nastea1/nfc_card/gallery/antenna.png

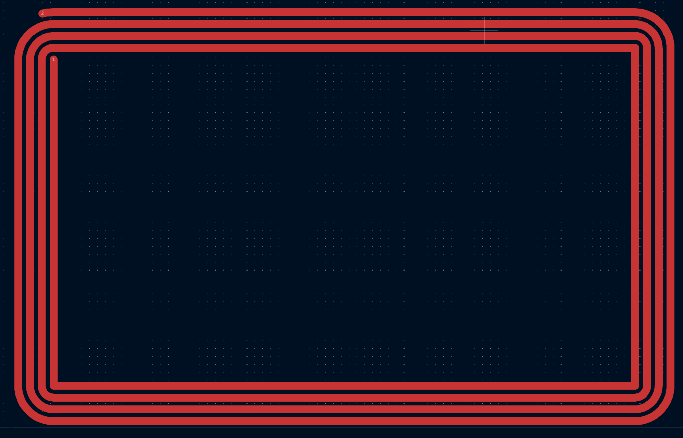
gallery/antenna.png
