nastea1/nfc_card/gallery/back.png

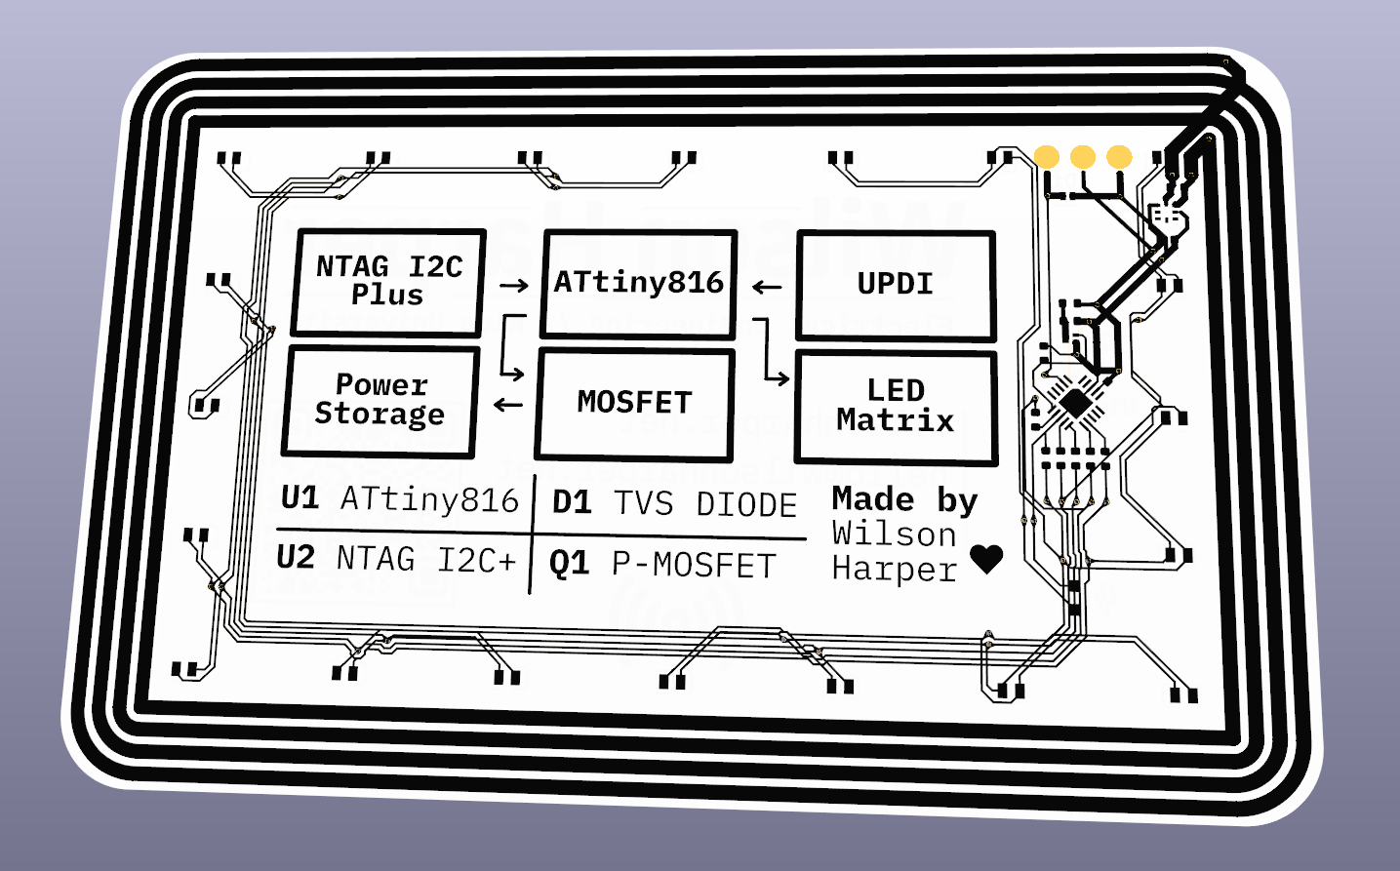
gallery/back.png
