nastea1/nfc_card/gallery/capacitor.png

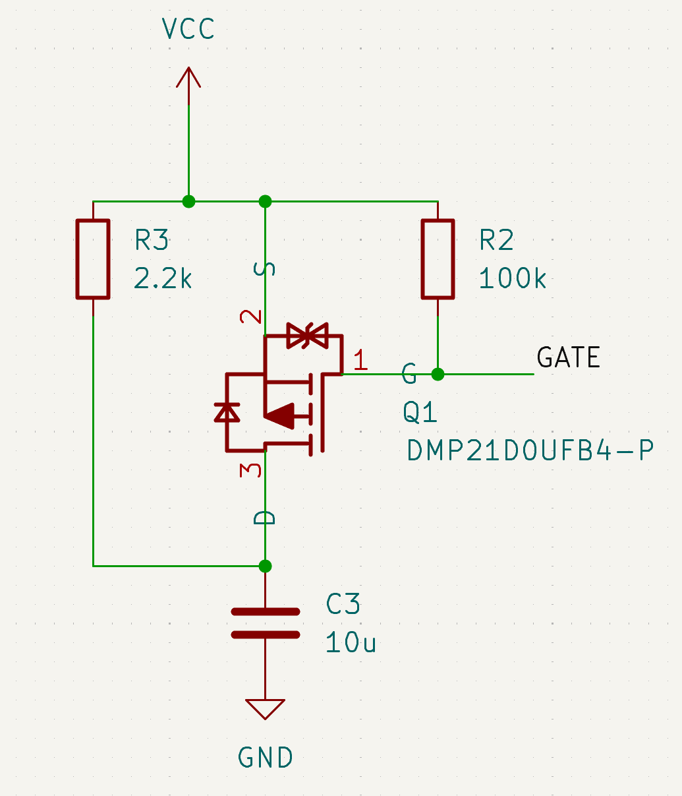
gallery/capacitor.png
