nastea1/nfc_card/gallery/in_hand.jpg

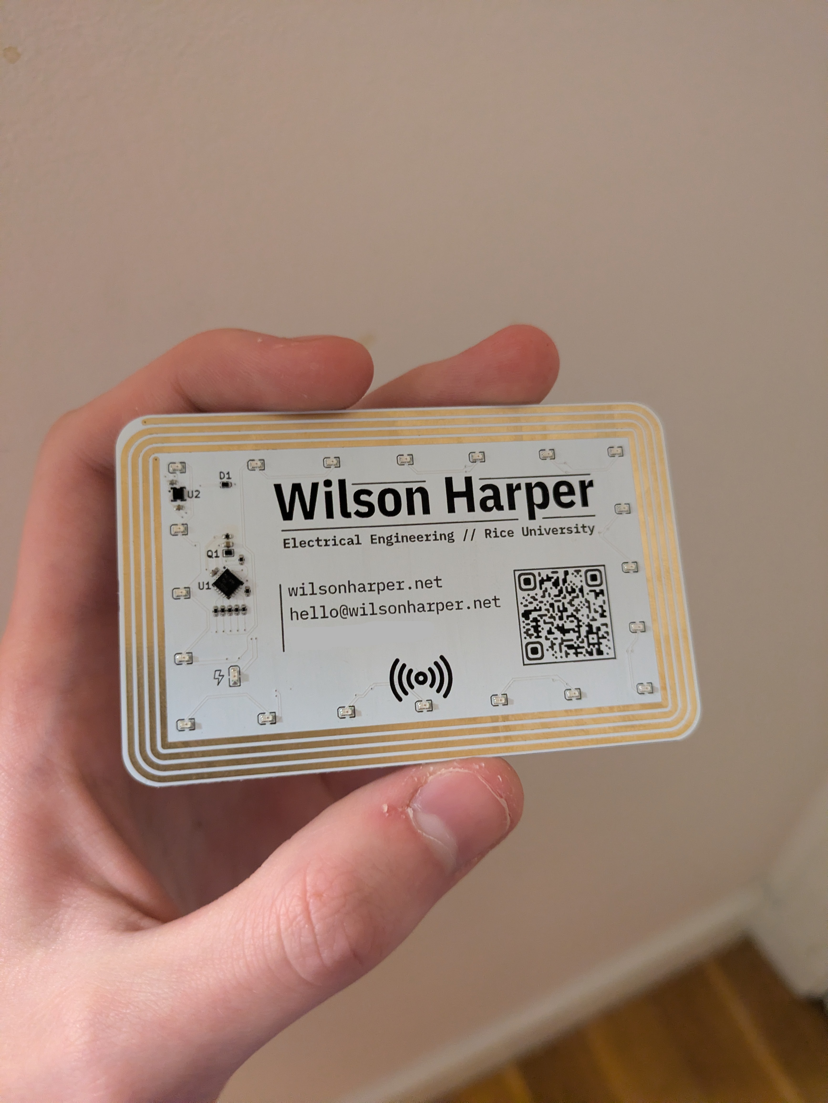
gallery/in_hand.jpg
