nastea1/nfc_card/gallery/in_hand_back.jpg

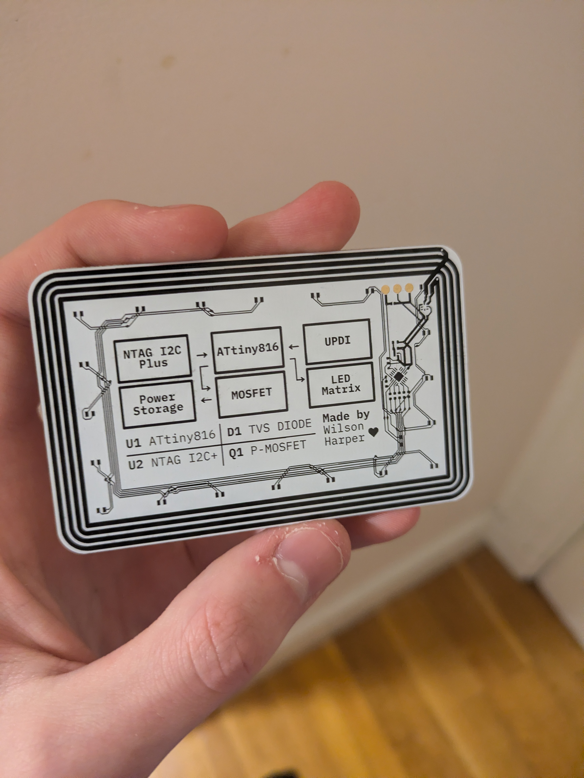
gallery/in_hand_back.jpg
