nastea1/nfc_card/gallery/new_sch.png

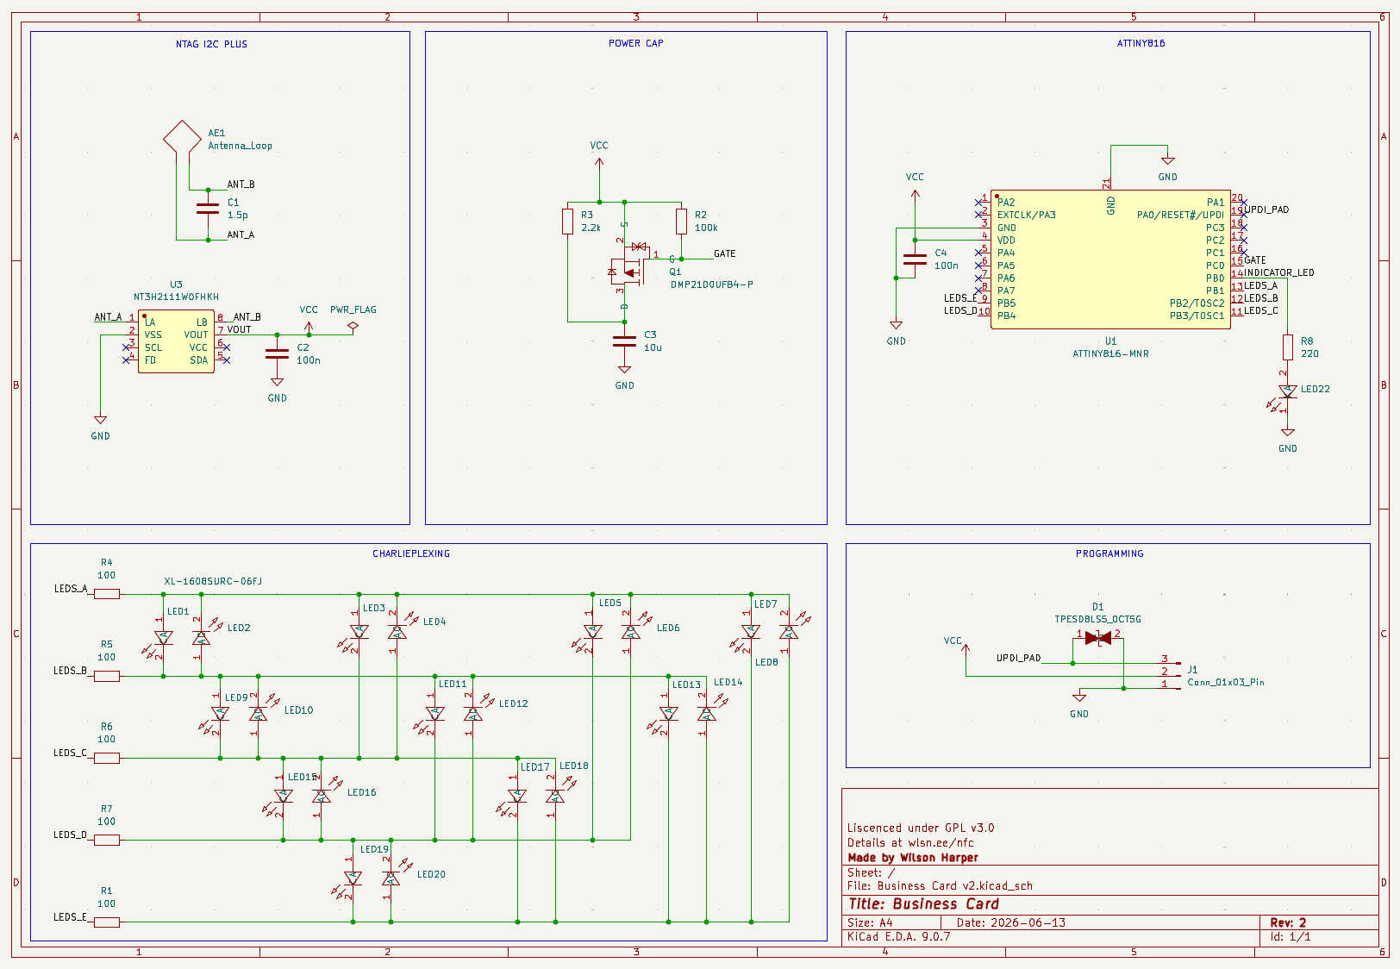
gallery/new_sch.png
