nastea1/nfc_card/gallery/pads.png

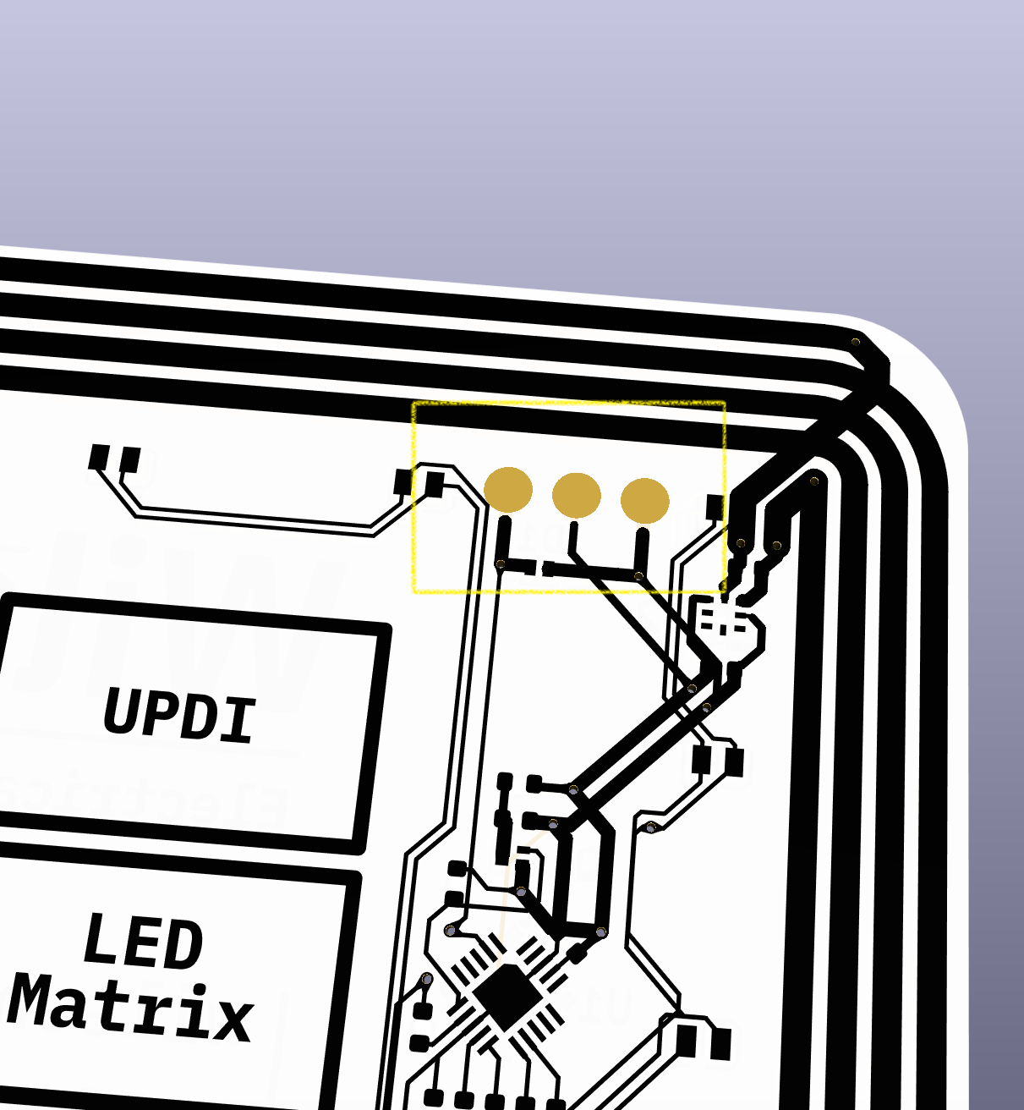
gallery/pads.png
