nastea1/nfc_card/gallery/sch1.png

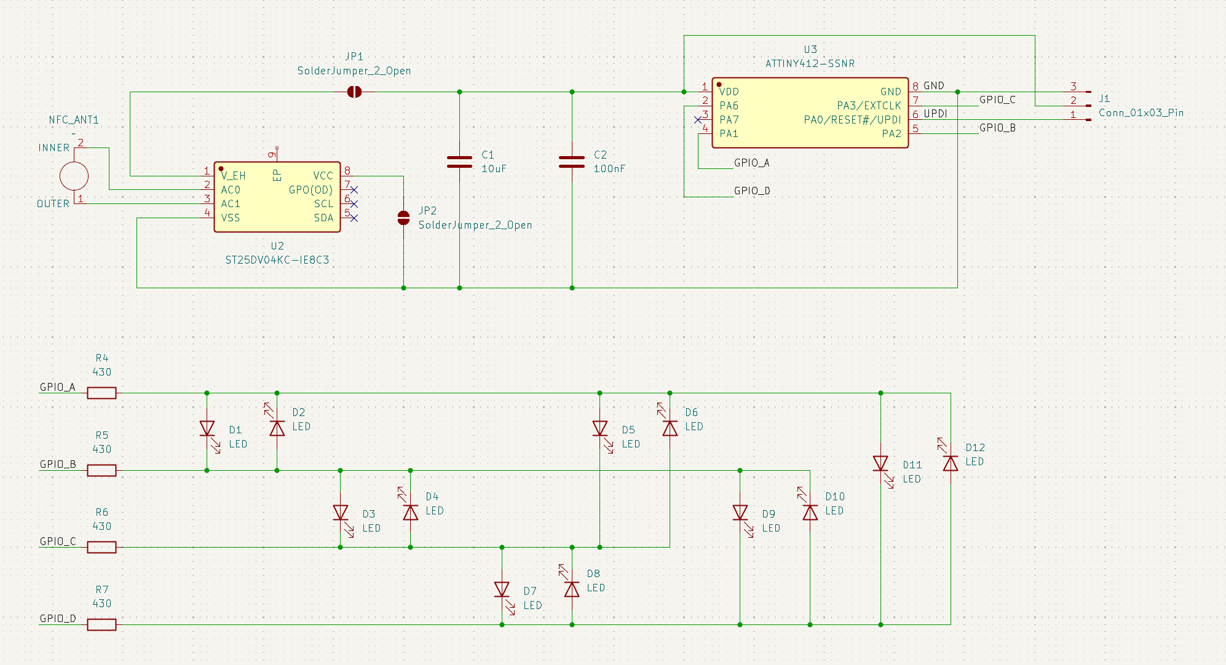
gallery/sch1.png
