nastea1/nfc_card/gallery/st_calc.png

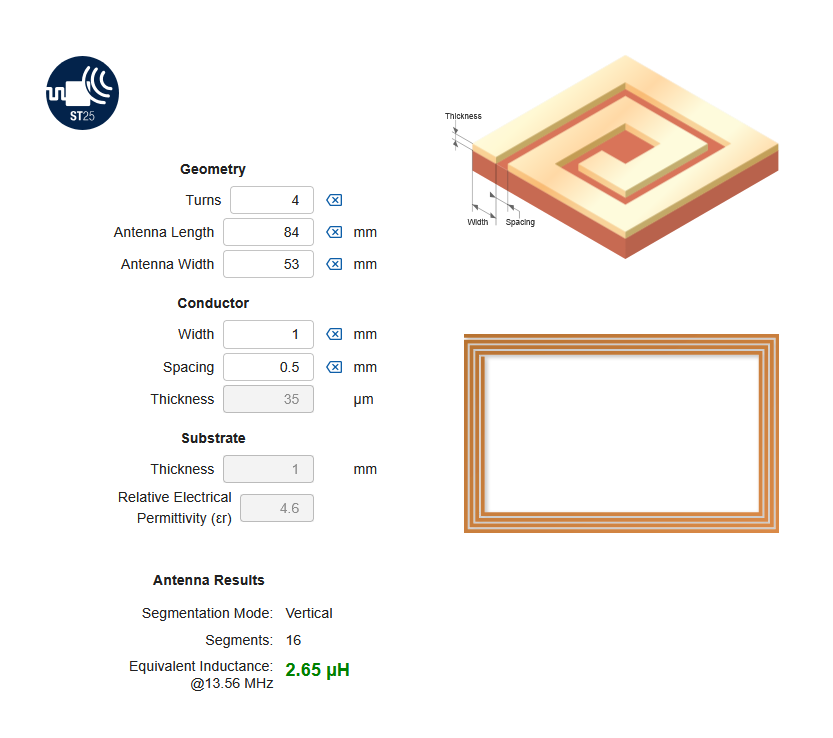
gallery/st_calc.png
