nastea1/nfc_card/gallery/stack.jpg

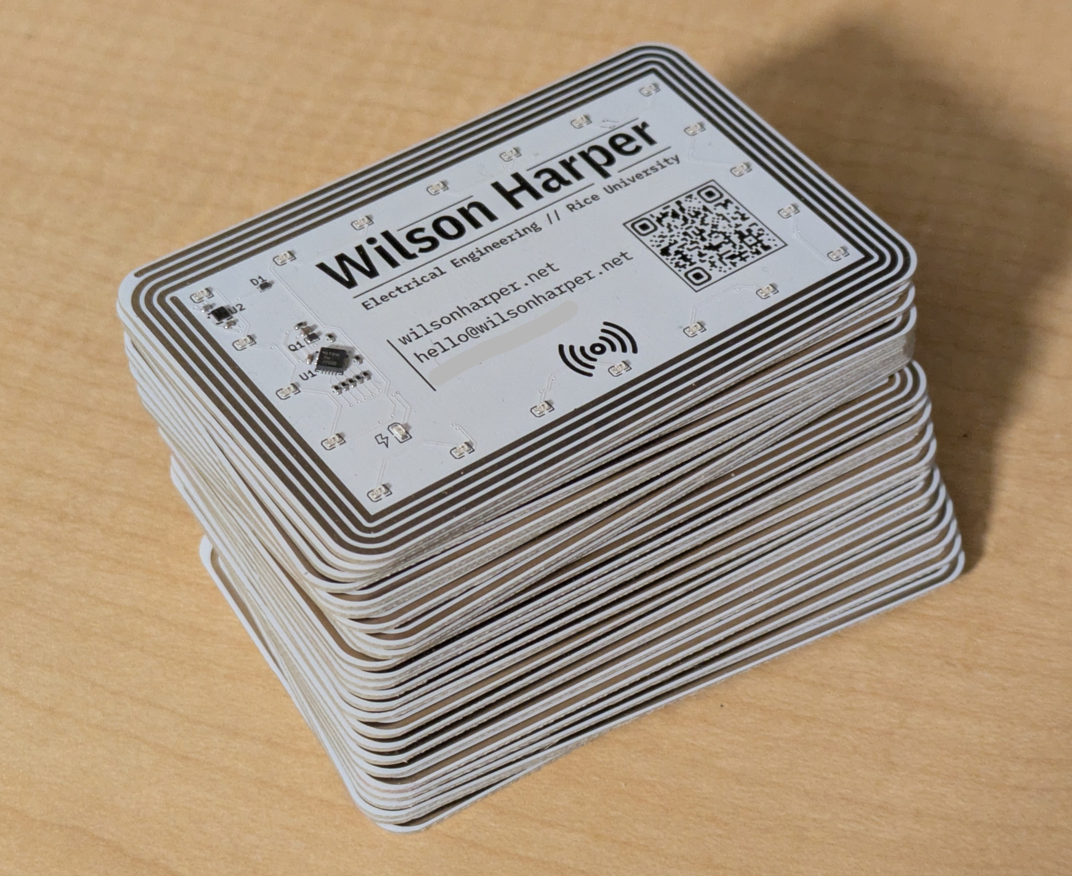
gallery/stack.jpg
