nastea1/nfc_card/hardware/Business Card v2.kicad_pcb

## KiCad design hardware/Business Card v2.kicad_pcb (2026-10-29)

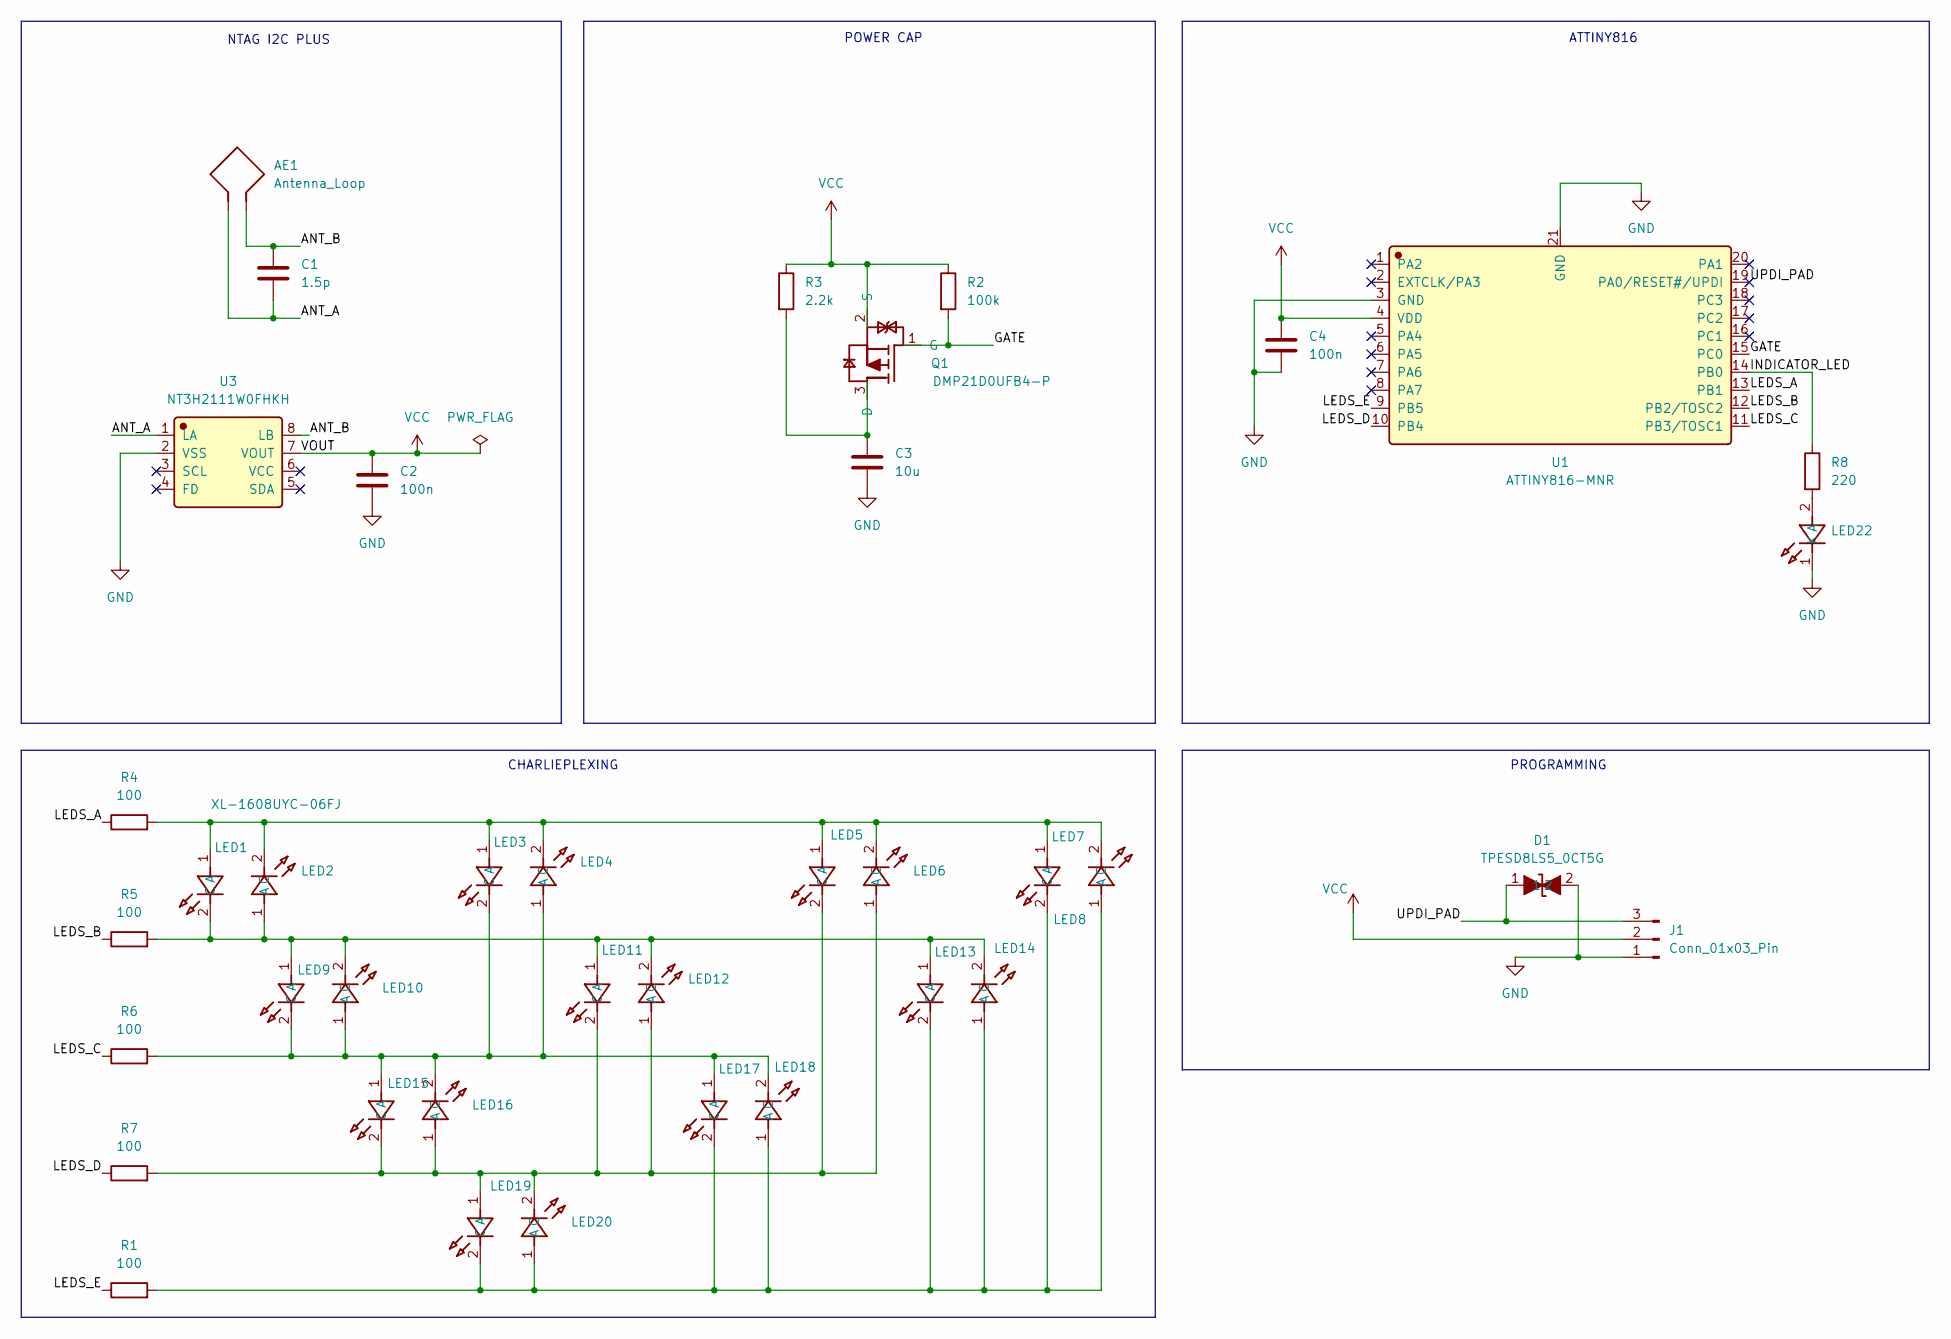
[picture p20: schematic Business Card v2.kicad_sch, Business Card]

Parts:
AE1: Antenna_Loop; Antenna V3
C1: 1.5p; C_0402_1005Metric; LCSC C1552
C2, C4: 100n; C_0402_1005Metric; LCSC C1525
C3: 10u; C_0402_1005Metric; LCSC C15525
D1: TPESD8LS5_0CT5G; TPESD8L3_3CT5G; Manufacturer Part TPESD8LS5.0CT5G; LCSC C2827551
J1: Conn_01x03_Pin; Offset UPDI
LED1, LED2, LED3, LED4, LED5, LED6, LED7, LED8, LED9, LED10, LED11, LED12, LED13, LED14, LED15, LED16, LED17, LED18, LED19, LED20: XL-1608UYC-06FJ; XL-1608SURC-06FJ; Manufacturer Part XL-1608UYC-06FJ; LCSC C7371901
LED22: XL-1608UYC-06FJ; Manufacturer Part XL-1608UYC-06FJ; LCSC C7371901
Q1: DMP21D0UFB4-P; Manufacturer Part DMP21D0UFB4-P; LCSC C2905648
R1, R4, R5, R6, R7: 100; R_0402_1005Metric; LCSC C25076
R2: 100k; R_0402_1005Metric; LCSC C25741
R3: 2.2k; R_0402_1005Metric; LCSC C25879
R8: 220; R_0402_1005Metric; LCSC C25091
U1: ATTINY816-MNR; Manufacturer Part ATTINY816-MNR; LCSC C2052778
U3: NT3H2111W0FHKH; Manufacturer Part NT3H2111W0FHKH; LCSC C710403

Connections:
/ANT_A: AE1.1, C1.2, U3.1 (LA)
/ANT_B: AE1.2, C1.1, U3.8 (LB)
/GATE: Q1.1 (G), R2.2, U1.15 (PC0)
/INDICATOR_LED: R8.1, U1.14 (PB0)
/LEDS_A: R4.1, U1.13 (PB1)
/LEDS_B: R5.1, U1.12 (PB2/TOSC2)
/LEDS_C: R6.1, U1.11 (PB3/TOSC1)
/LEDS_D: R7.1, U1.10 (PB4)
/LEDS_E: R1.1, U1.9 (PB5)
/UPDI_PAD: D1.1, J1.3, U1.19 (PA0/RESET#/UPDI)
GND: C2.2, C3.2, C4.2, D1.2, J1.1, LED22.1 (K), U1.3 (GND), U1.21 (GND), U3.2 (VSS)
unnamed: LED1.1 (A), LED2.2 (C), LED3.1 (A), LED4.2 (C), LED5.1 (A), LED6.2 (C), LED7.2 (C), LED8.1 (A), R4.2
unnamed: LED1.2 (C), LED2.1 (A), LED9.1 (A), LED10.2 (C), LED11.1 (A), LED12.2 (C), LED13.1 (A), LED14.2 (C), R5.2
unnamed: LED3.2 (C), LED4.1 (A), LED9.2 (C), LED10.1 (A), LED15.1 (A), LED16.2 (C), LED17.1 (A), LED18.2 (C), R6.2
unnamed: LED5.2 (C), LED6.1 (A), LED11.2 (C), LED12.1 (A), LED15.2 (C), LED16.1 (A), LED19.1 (A), LED20.2 (C), R7.2
unnamed: LED7.1 (A), LED8.2 (C), LED13.2 (C), LED14.1 (A), LED17.2 (C), LED18.1 (A), LED19.2 (C), LED20.1 (A), R1.2
unnamed: LED22.2 (A), R8.2
unnamed: C3.1, Q1.3 (D), R3.2
VCC: C2.1, C4.1, J1.2, Q1.2 (S), R2.1, R3.1, U1.4 (VDD), U3.7 (VOUT)

Notes on the sheet:
NTAG I2C PLUS
POWER CAP
ATTINY816
PROGRAMMING
CHARLIEPLEXING

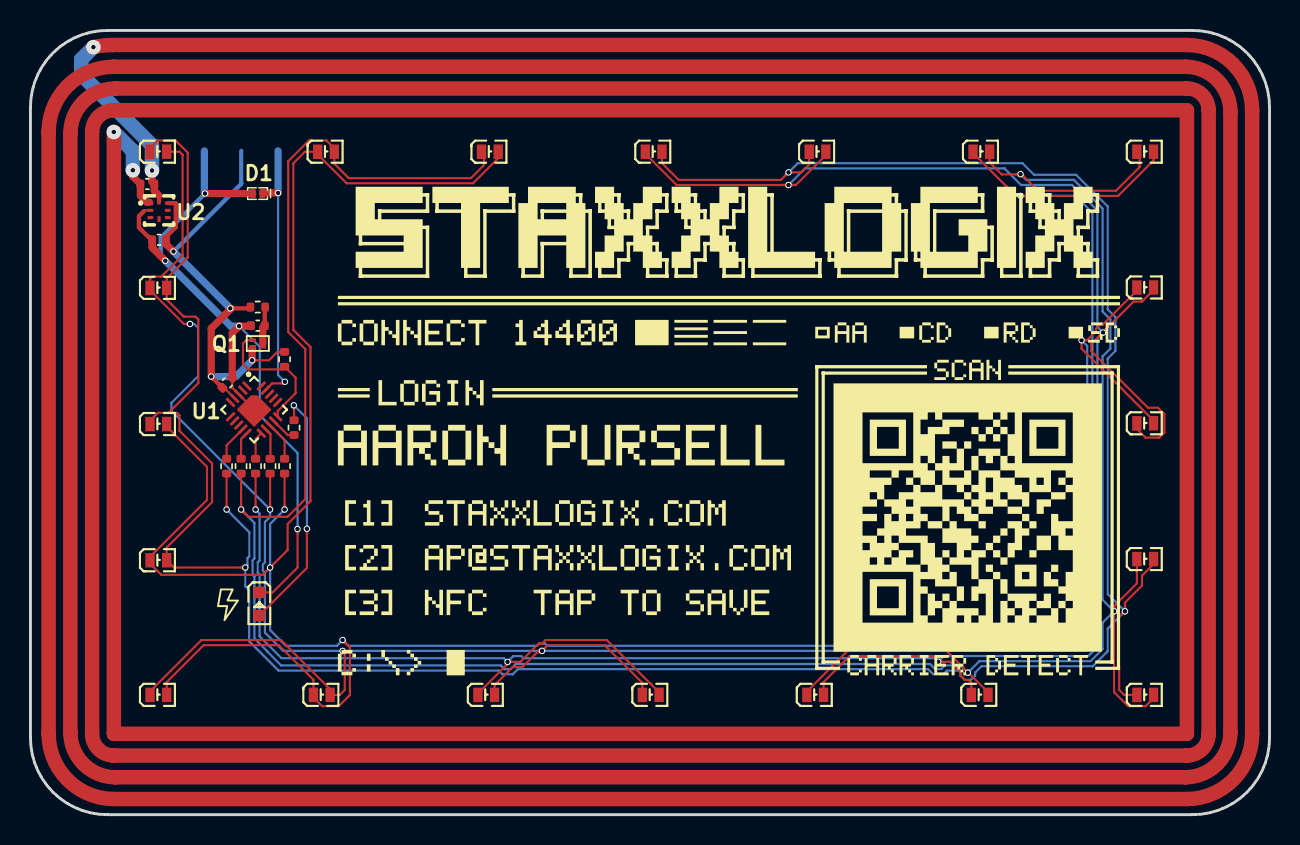
[picture p21: board Business Card v2.kicad_pcb from above]

Board: 2 copper layers, 85.4 x 54.1 mm, 39 parts (1 on the bottom side), 19 nets.
