nastea1/nfc_card/(notices)

Notices in the files:
hardware/Business Card v2.kicad_sch:
Liscenced under GPL v3.0
hardware/Business Card v2.kicad_pcb:
This fork: hardware CERN-OHL-S-2.0 (LICENSE.md); src github.com/nastea1/nfc_card
